ossilampe/Buderus-Waermepumpe_Home_Assistant/docs/innen-verkabelung.jpg

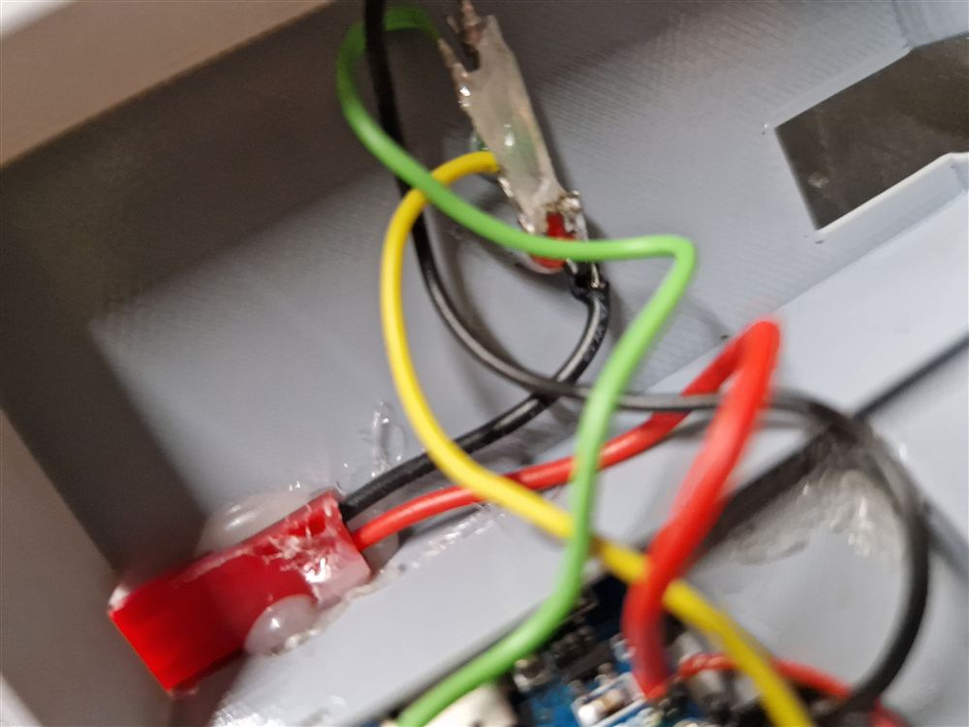
docs/innen-verkabelung.jpg
