ossilampe/Buderus-Waermepumpe_Home_Assistant/3D-Druck/Tastfläche.stl

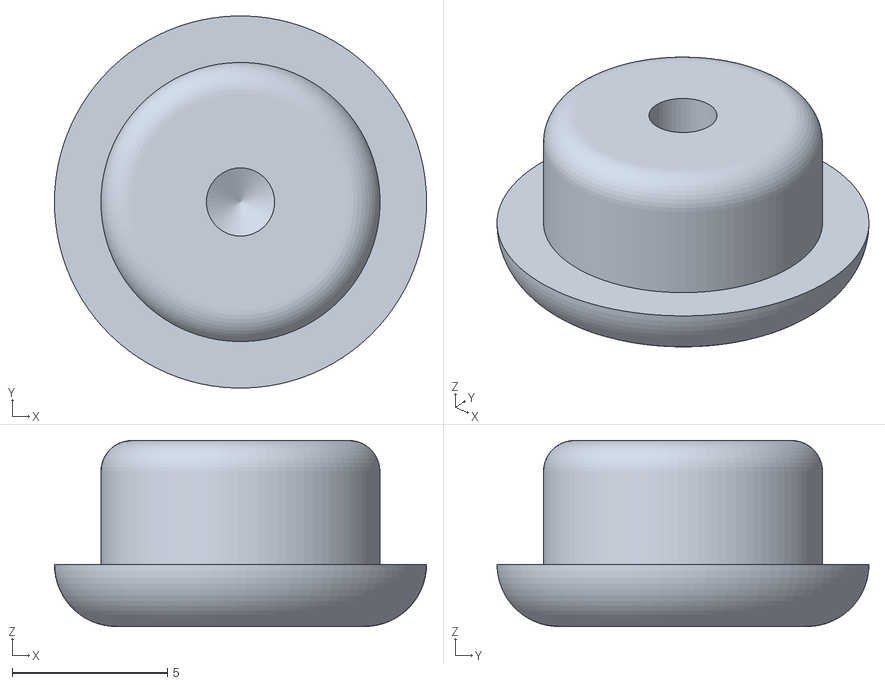
[picture p12: CAD file, 2026-10-25]
3D-Druck/Tastfläche.stl
12.0 x 12.0 x 6.00
