ossilampe/Buderus-Waermepumpe_Home_Assistant/3D-Druck/Finger_2.stl

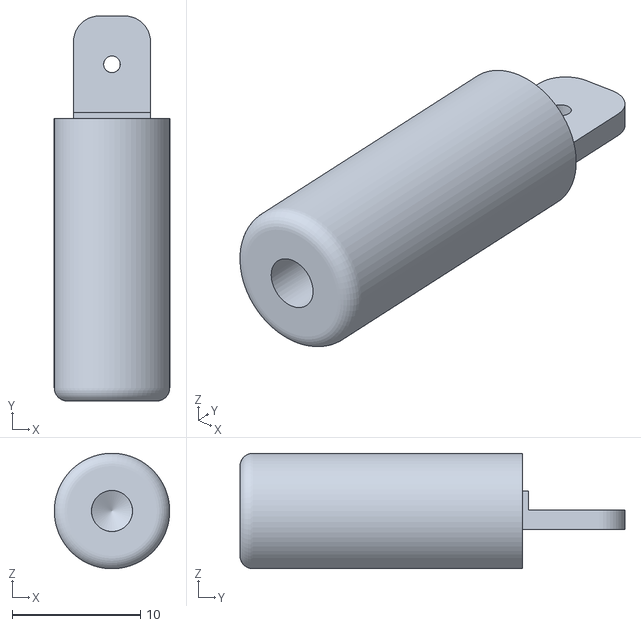
[picture p13: CAD file, 2026-10-25]
3D-Druck/Finger_2.stl
9.00 x 30.0 x 8.99
