ossilampe/Buderus-Waermepumpe_Home_Assistant/3D-Druck/Servo_montage_platte.stl

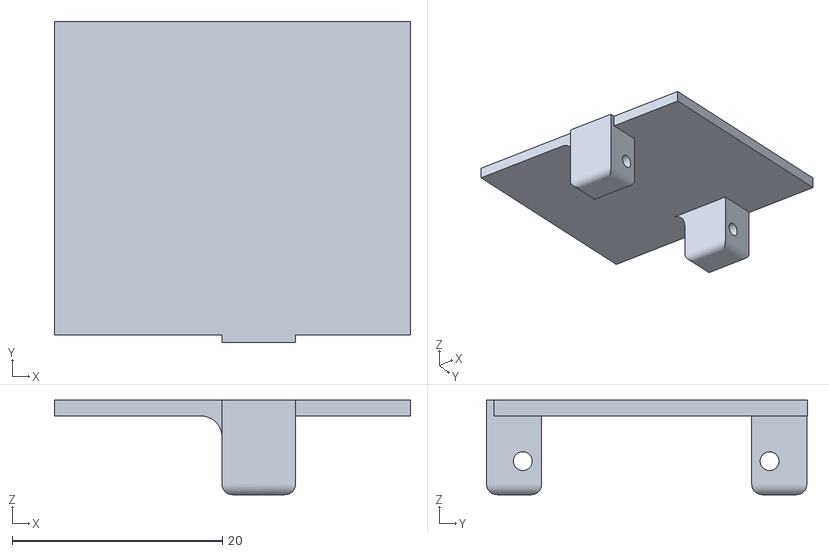
[picture p14: CAD file, 2026-10-25]
3D-Druck/Servo_montage_platte.stl
33.9 x 30.6 x 9.00
