ossilampe/Buderus-Waermepumpe_Home_Assistant/3D-Druck/Deckel.stl

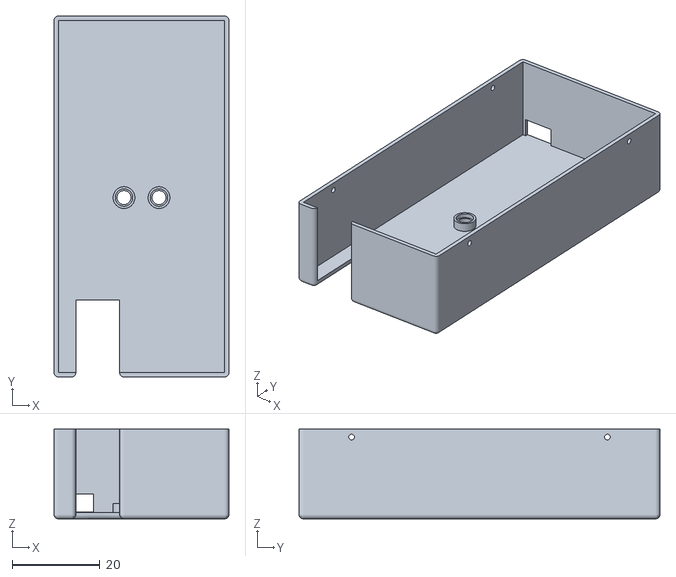
[picture p15: CAD file, 2026-10-25]
3D-Druck/Deckel.stl
40.0 x 82.5 x 20.5
