ossilampe/Buderus-Waermepumpe_Home_Assistant/3D-Druck/Back.stl

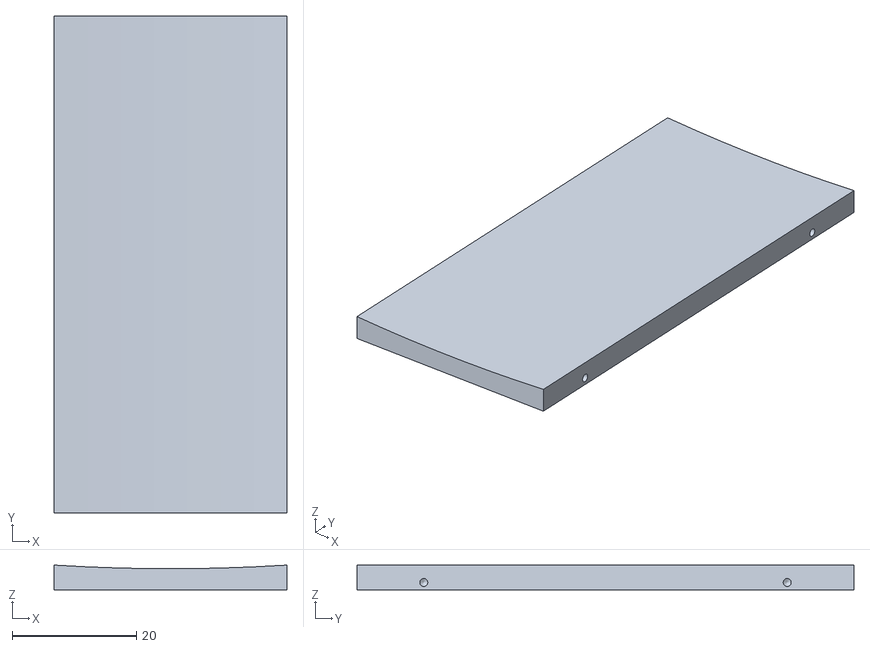
[picture p16: CAD file, 2026-10-25]
3D-Druck/Back.stl
37.5 x 80.0 x 4.00
