ossilampe/Buderus-Waermepumpe_Home_Assistant/3D-Druck/Finger_1.stl

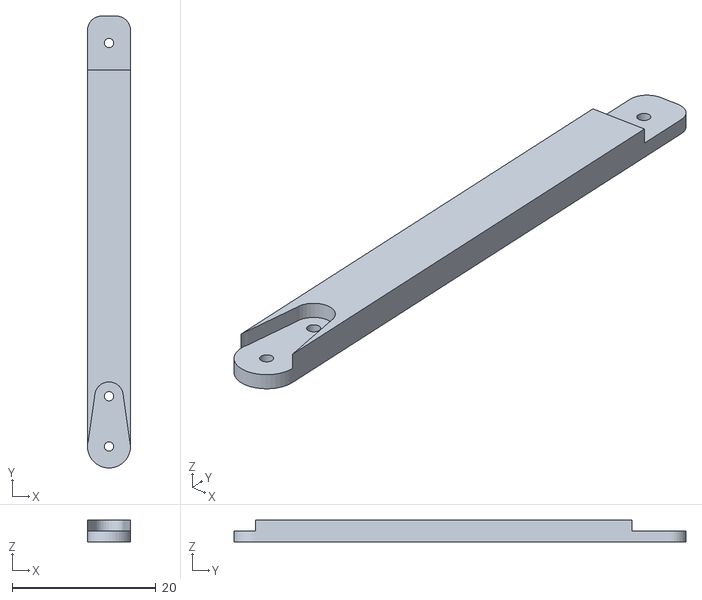
[picture p17: CAD file, 2026-10-25]
3D-Druck/Finger_1.stl
6.00 x 63.0 x 3.00
