ossilampe/Buderus-Waermepumpe_Home_Assistant/(list of files, cad)

Other CAD files:
3D-Druck/WP_Switch v2.f3d
